Nitrokey/nitrokey-pro-gd32-hardware/manufacturing-outputs/nkpro-r5-assembly/nkprov5-BOM.xlsx

Id | Designator | Package | Quantity | Designation | Digikey Part Number | Digikey URL | Availability
1 | C3,C7,C6,C5,C4,C8 | c_0402 | 6 | 0.1uF | 20% tol | https://www.digikey.com/en/products/detail/kyocera-avx/0402ZD104MAT4A/8107676
2 | R1,R2 | r_0402 | 2 | 499R | 1% tol | https://www.digikey.com/en/products/detail/yageo/RC0402FR-07499RL/726623
3 | C1,C2 | c_0402 | 2 | 4.7pF | 10% tol | https://www.digikey.com/en/products/detail/murata-electronics/GJM1555C1H4R7CB01D/702293
4 | C9,C11 | c_0402 | 2 | 4.7uF | 20% tol | https://www.digikey.com/en/products/detail/murata-electronics/GRM155R60J475ME47D/3694656
5 | U2 | X2SON | 1 | AP7340-33FS4-7 | AP7340-33FS4-7DITR-ND | https://www.digikey.de/product-detail/de/diodes-incorporated/AP7340-33FS4-7/AP7340-33FS4-7DITR-ND/4570662 | 90000
6 | U1 | LQFP48 | 1 | GD32F103CBT6 | winsource GD32F103CBT6 | https://www.win-source.net/hot-sales-and-eol-components-gd32f103cbt6.html | 8600
7 | X1 | Xtal-4-2520-metric | 1 | 8Z-12.000MAAJ-T | 887-1487-2-ND | https://www.digikey.de/product-detail/en/txc-corporation/8Z-12-000MAAJ-T/887-1487-2-ND/2627003 | 18000
8 | R3,R4 | c_0402 | 2 | 10k | 1% tol | https://www.digikey.com/en/products/detail/samsung-electro-mechanics/RC1005F103CS/3903439
9 | U3 | SOT-553 | 1 | DF5A5.6JE | DF5A5.6CJE,LM | https://www.digikey.de/product-detail/de/toshiba-semiconductor-and-storage/DF5A5-6CJE-LM/DF5A5-6CJE-LMTR-ND/4305072 | 40000
10 | J2 | USB-A-PLUG | 1 | USB_A | WM3983TR-ND | https://www.digikey.de/product-detail/de/molex/0480372200/WM3983TR-ND/2421361 | 26000
11 | D1 | KPHBM-2012SURKCGKC | 1 | DUAL_LED | 754-1093-2-ND | https://www.digikey.de/product-detail/de/kingbright/APHBM2012SURKCGKC/754-1093-2-ND/1747491 | 330000
12 | J1 | Molex 0786463001 | 1 | SIM_JACKET | WM9364CT-ND | http://www.digikey.com/product-detail/en/0786463001/WM9364CT-ND/3770350 | 235000
13 | R7 | r_0402 | 1 | 1.5k | 311-1.50KLRCT-ND | https://www.digikey.com/product-detail/en/yageo/RC0402FR-071K5L/311-1.50KLRCT-ND/729466
14 | R5,R6 | r_0402 | 2 | 22R | 311-22.0LRCT-ND | https://www.digikey.com/product-detail/en/yageo/RC0402FR-0722RL/311-22.0LRCT-ND/729509
