Nitrokey/nitrokey-pro-gd32-hardware/nkpror5-schematic.pdf

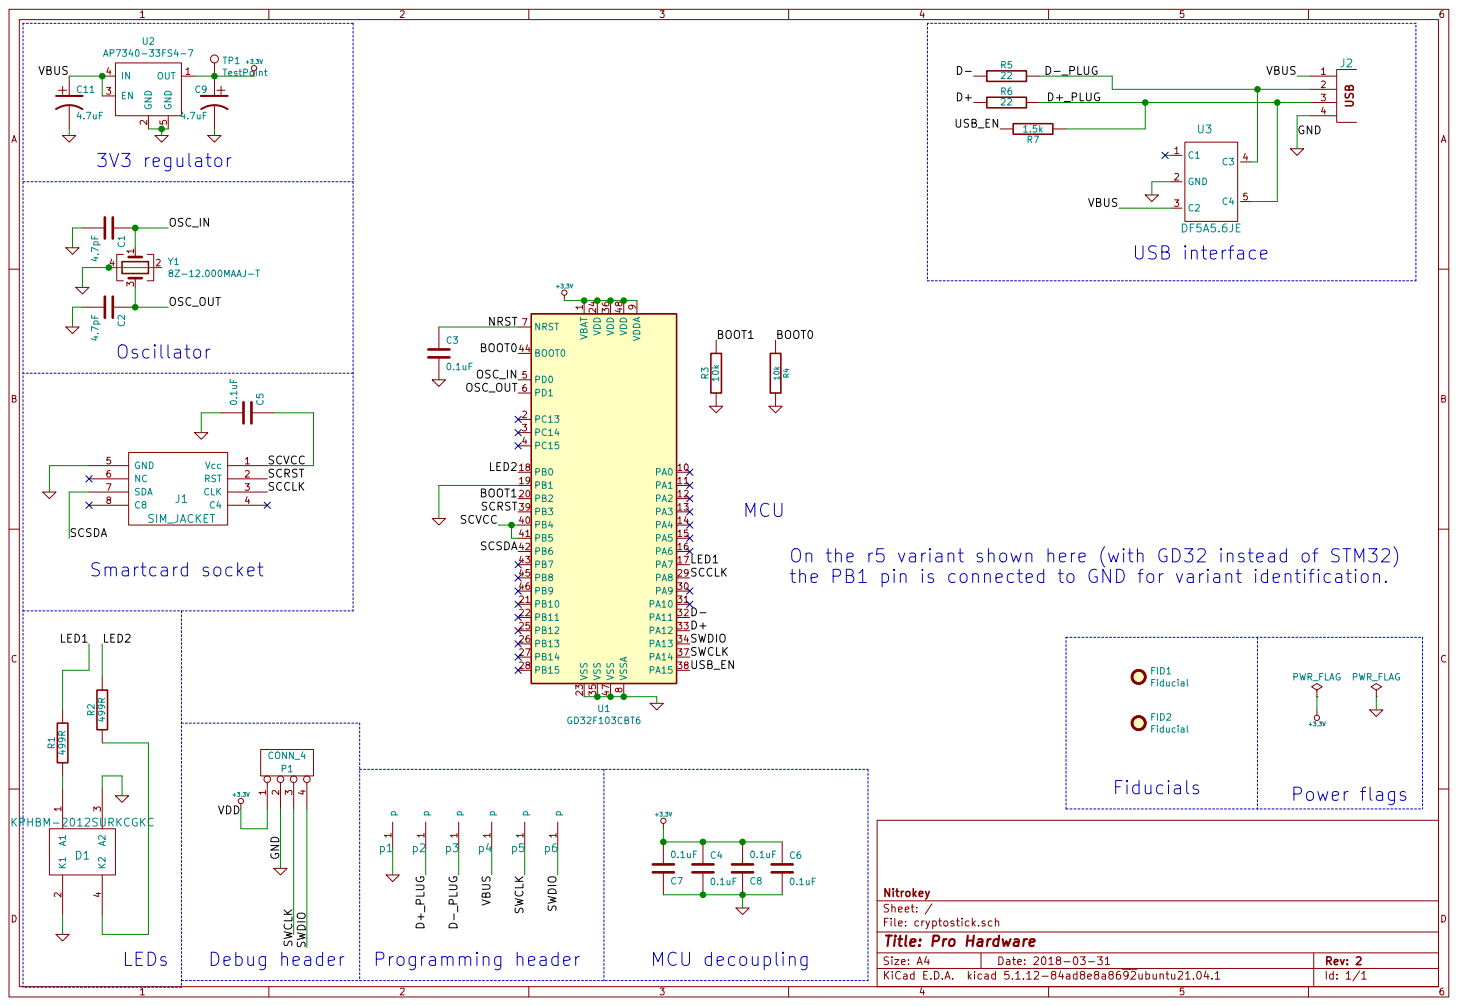
[picture p1: page 1]

1 VDD 24 VDD 36 VDD 48 VDDA

9 VSS 23 VSS 35 VSS 47 VSSA

SCSDA VBUS SWCLK SWDIO

On the r5 variant shown here (with GD32 instead of STM32)
the PB1 pin is connected to GND for variant identification.

Id: 1/1 Title: Pro Hardware
