Nitrokey/nitrokey-pro-gd32-hardware/cryptostick.kicad_pcb

## KiCad design cryptostick.kicad_pcb (2021-12-06)

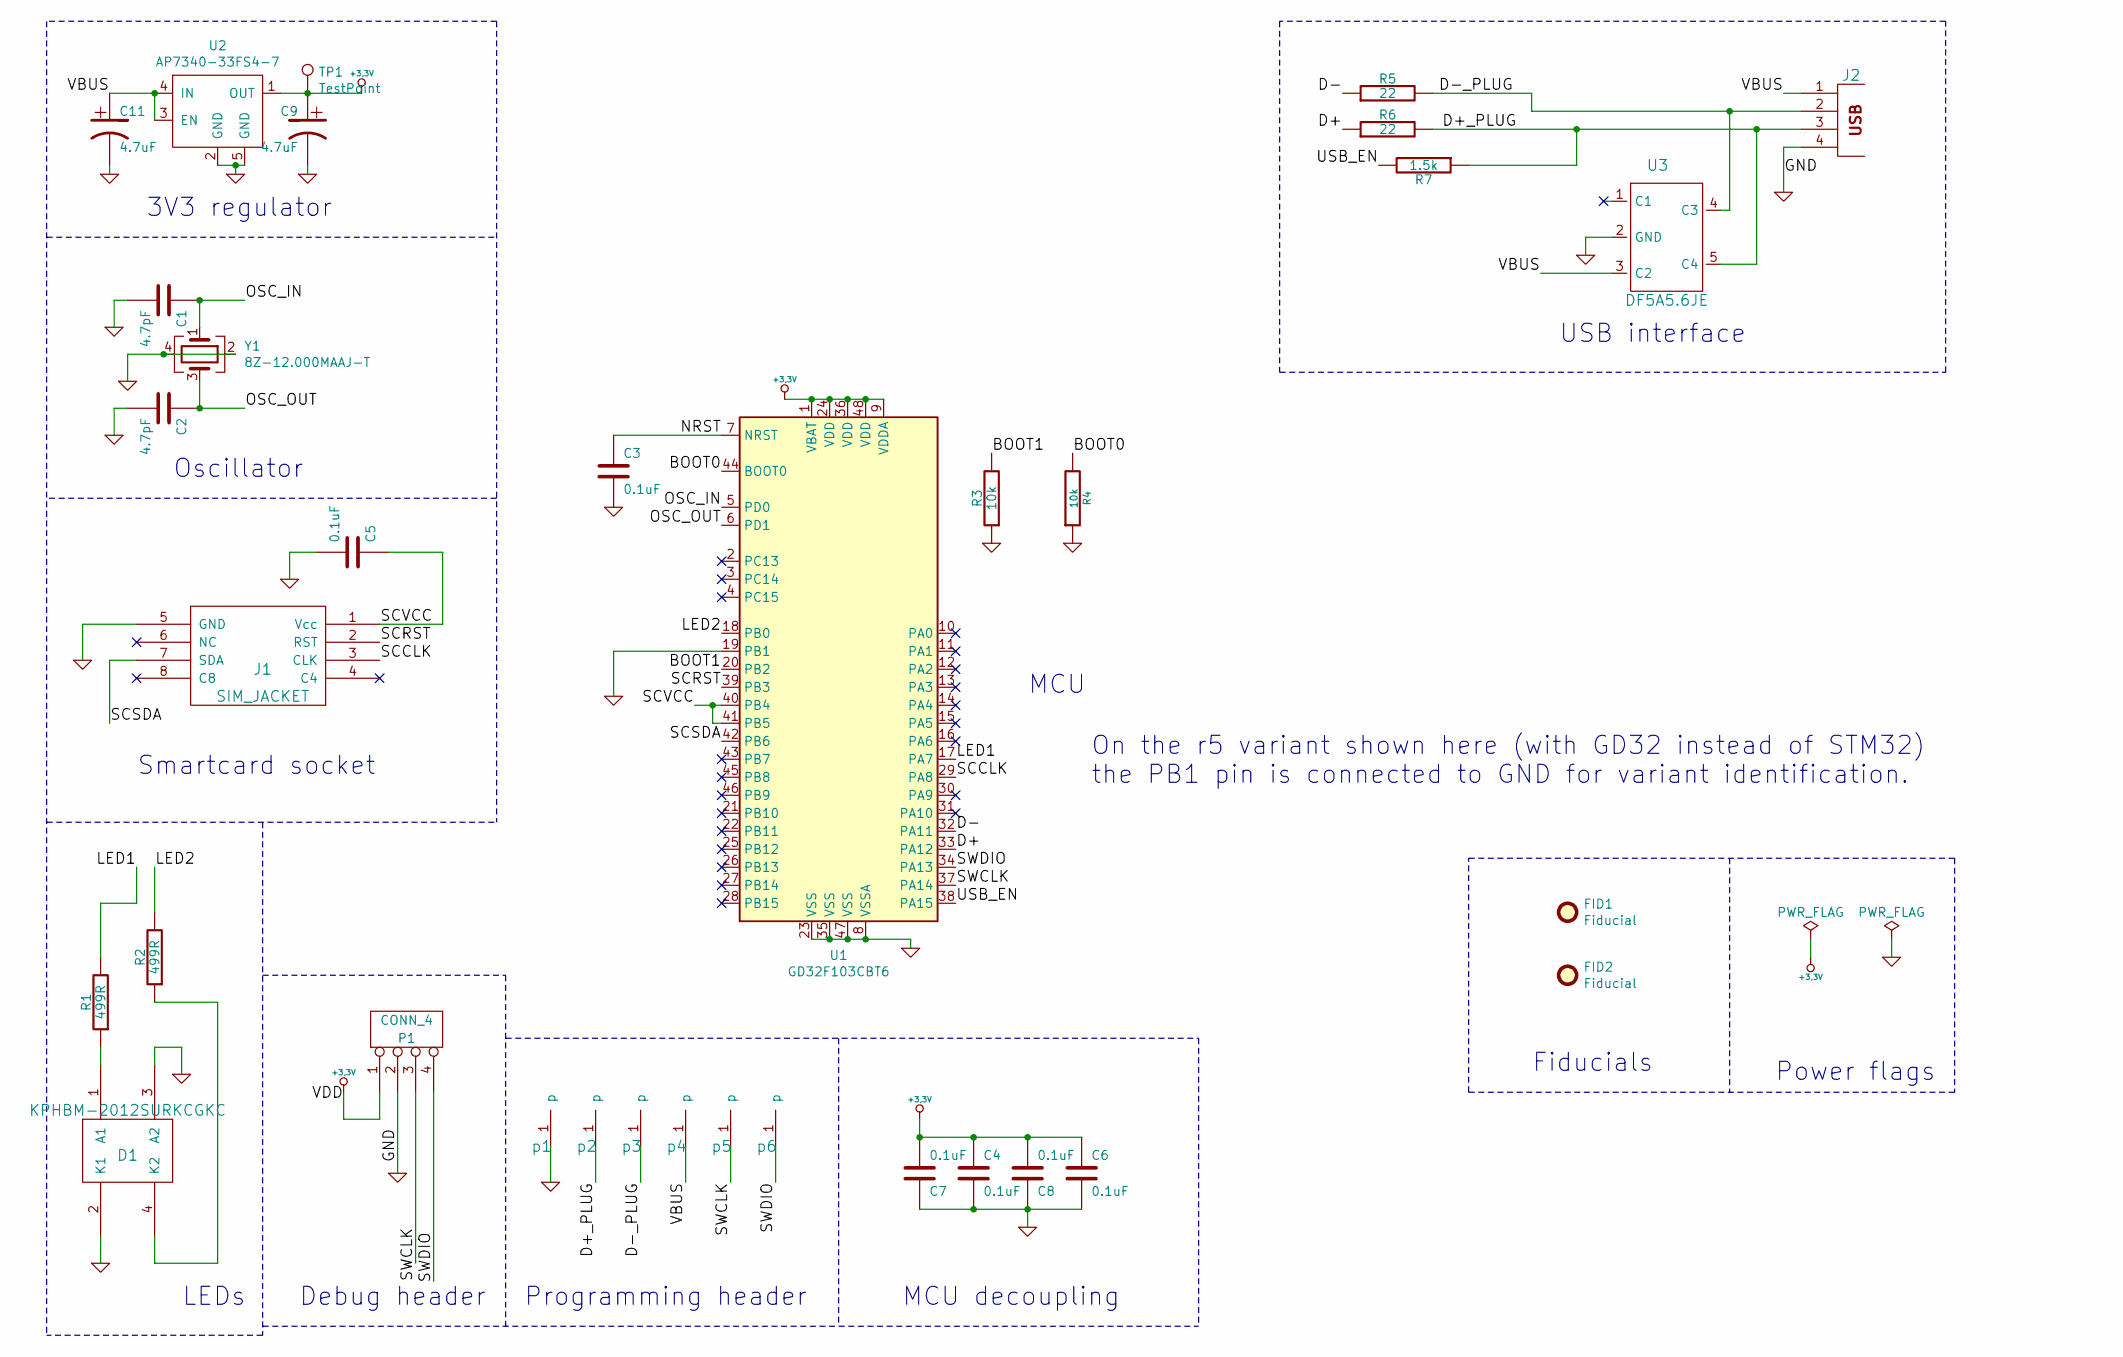
[picture p2: schematic cryptostick.sch, Pro Hardware]

Parts:
C1, C2: 4.7pF; C_0402_1005Metric
C3, C4, C5, C6, C7, C8: 0.1uF; C_0402_1005Metric
C9, C11: 4.7uF; C_0402_1005Metric
D1: KPHBM-2012SURKCGKC
FID1, FID2: Fiducial; Fiducial_0.75mm_Mask1.5mm
J1: SIM_JACKET; molex 78646-3001
J2: USB_A; USB-A-PLUG
P1: CONN_4; SIL-2-2-drilled-offset
R1, R2: 499R; R_0402_1005Metric
R3, R4: 10k; R_0402_1005Metric
R5, R6: 22; R_0402_1005Metric
R7: 1.5k; R_0402_1005Metric
TP1: TestPoint; TestPoint_Pad_D1.5mm
U1: GD32F103CBT6; LQFP-48_7x7mm_P0.5mm
U2: AP7340-33FS4-7; Texas_X2SON-4_1x1mm_P0.65mm; MPN TLV74233PDQNR
U3: DF5A5.6JE; SOT-553
Y1: 8Z-12.000MAAJ-T; Crystal_SMD_2520-4Pin_2.5x2.0mm
p1, p2, p3, p5, p6: debug-pin; Prog_Pad_Circular
p4: PROG_VCC; Prog_Pad_Circular

Connections:
+3.3V: C4.1, C6.1, C7.2, C8.2, C9.1, P1.1, TP1.1, U1.1 (VBAT), U1.9 (VDDA), U1.24 (VDD), U1.36 (VDD), U1.48 (VDD), U2.1 (OUT)
/BOOT0: R4.2, U1.44 (BOOT0)
/BOOT1: R3.2, U1.20 (PB2)
/D+: R6.1, U1.33 (PA12)
/D+_PLUG: J2.3, R6.2, R7.1, U3.5 (C4), p2.1
/D-: R5.1, U1.32 (PA11)
/D-_PLUG: J2.2, R5.2, U3.4 (C3), p3.1
/LED1: R1.2, U1.17 (PA7)
/LED2: R2.2, U1.18 (PB0)
/NRST: C3.1, U1.7 (NRST)
/OSC_IN: C1.1, U1.5 (PD0), Y1.1
/OSC_OUT: C2.1, U1.6 (PD1), Y1.3
/SCCLK: J1.3 (CLK), U1.29 (PA8)
/SCRST: J1.2 (RST), U1.39 (PB3)
/SCSDA: J1.7 (SDA), U1.42 (PB6)
/SCVCC: C5.1, J1.1 (Vcc), U1.40 (PB4), U1.41 (PB5)
/SWCLK: P1.3, U1.37 (PA14), p5.1
/SWDIO: P1.4, U1.34 (PA13), p6.1
/USB_EN: R7.2, U1.38 (PA15)
/VBUS: C11.1, J2.1, U2.3 (EN), U2.4 (IN), U3.3 (C2), p4.1
unnamed: D1.1 (A1), R1.1
unnamed: D1.4 (K2), R2.1

Notes on the sheet:
MCU decoupling
Programming header
Debug header
LEDs
Smartcard socket
Oscillator
3V3 regulator
USB interface
MCU
Fiducials
Power flags
On the r5 variant shown here (with GD32 instead of STM32) the PB1 pin is connected to GND for variant identification.

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
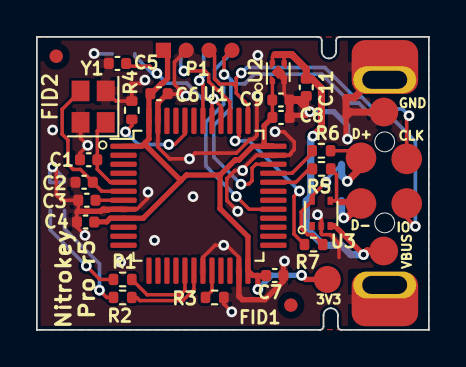
[picture p3: board cryptostick.kicad_pcb from above]

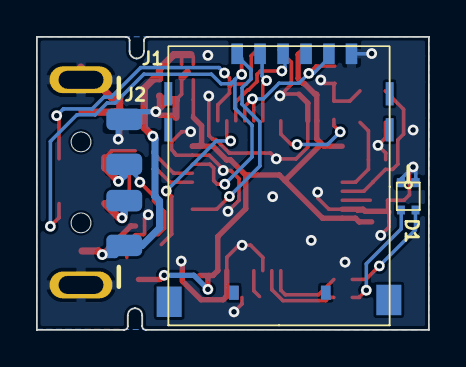
[picture p4: board cryptostick.kicad_pcb from below]

Board: 2 copper layers, 21.8 x 16.3 mm, 34 parts (3 on the bottom side), 23 nets.
